justinc324/processing_printer/BrachioGraph/docs/images/anselmo.jpg

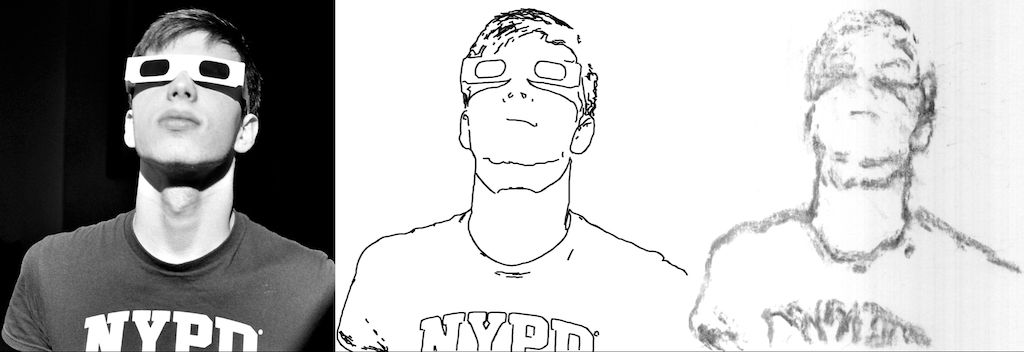
BrachioGraph/docs/images/anselmo.jpg
