justinc324/processing_printer/BrachioGraph/docs/images/brachiograph-clothespeg-closeup.jpg

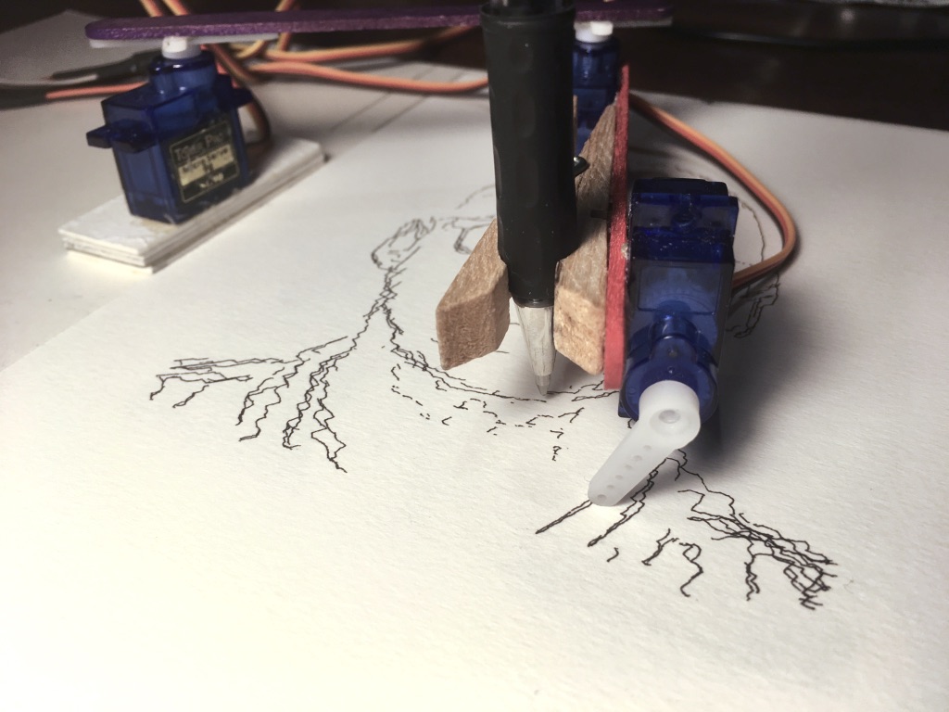
BrachioGraph/docs/images/brachiograph-clothespeg-closeup.jpg
