justinc324/processing_printer/BrachioGraph/docs/images/brachiograph-with-card.jpg

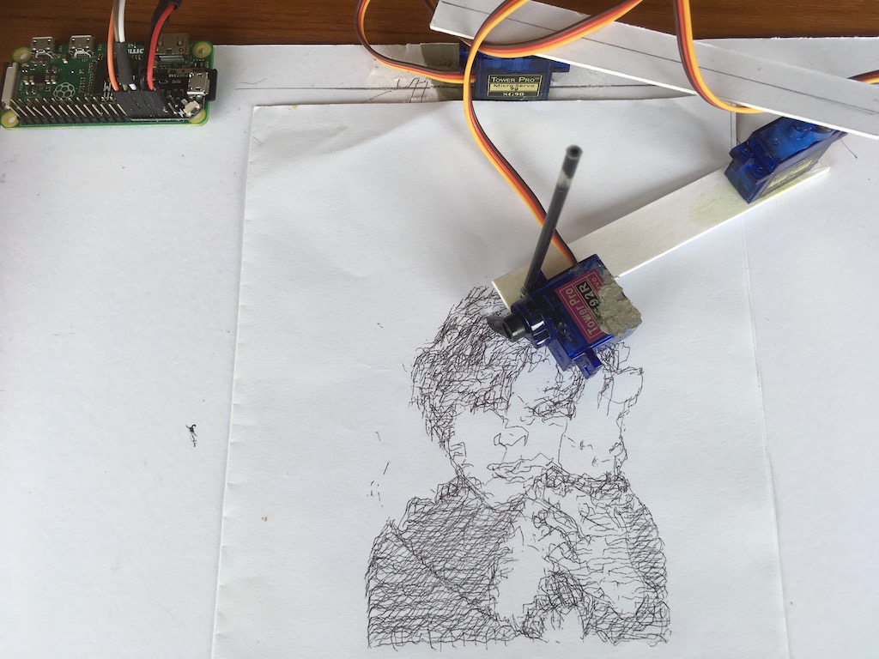
BrachioGraph/docs/images/brachiograph-with-card.jpg
