justinc324/processing_printer/BrachioGraph/docs/images/brachiograph-with-pencil.jpg

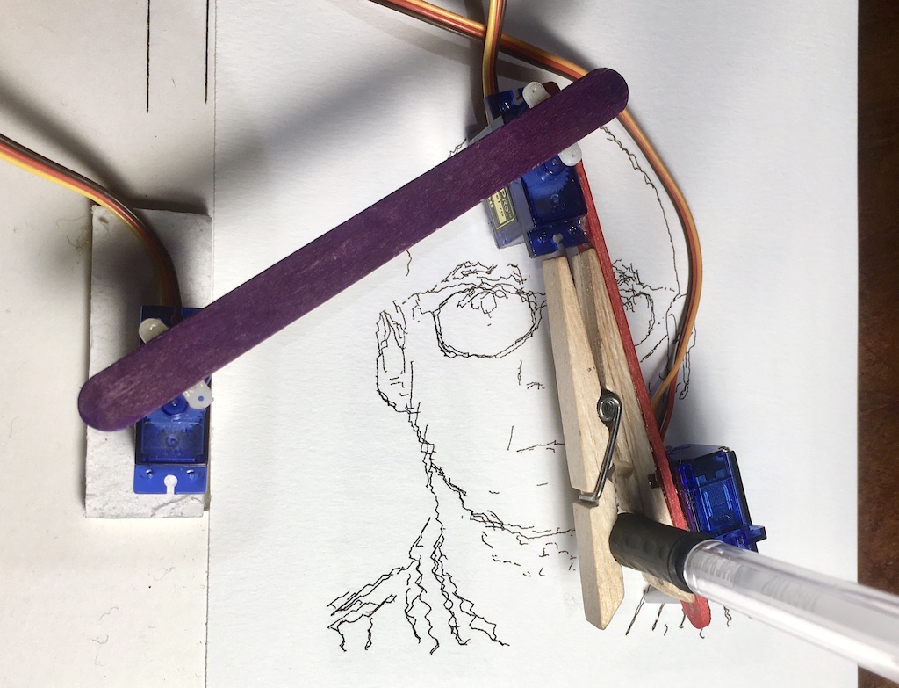
BrachioGraph/docs/images/brachiograph-with-pencil.jpg
