justinc324/processing_printer/BrachioGraph/docs/images/card-arms-and-motors.jpg

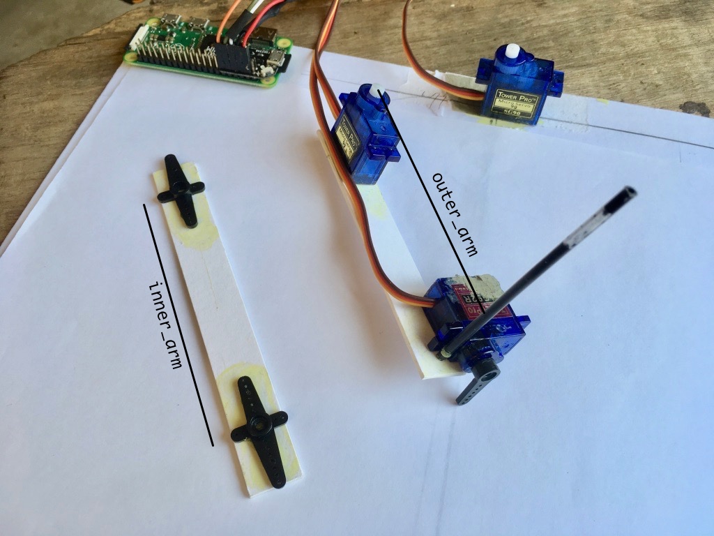
BrachioGraph/docs/images/card-arms-and-motors.jpg
