justinc324/processing_printer/BrachioGraph/docs/images/card-starting-position.jpg

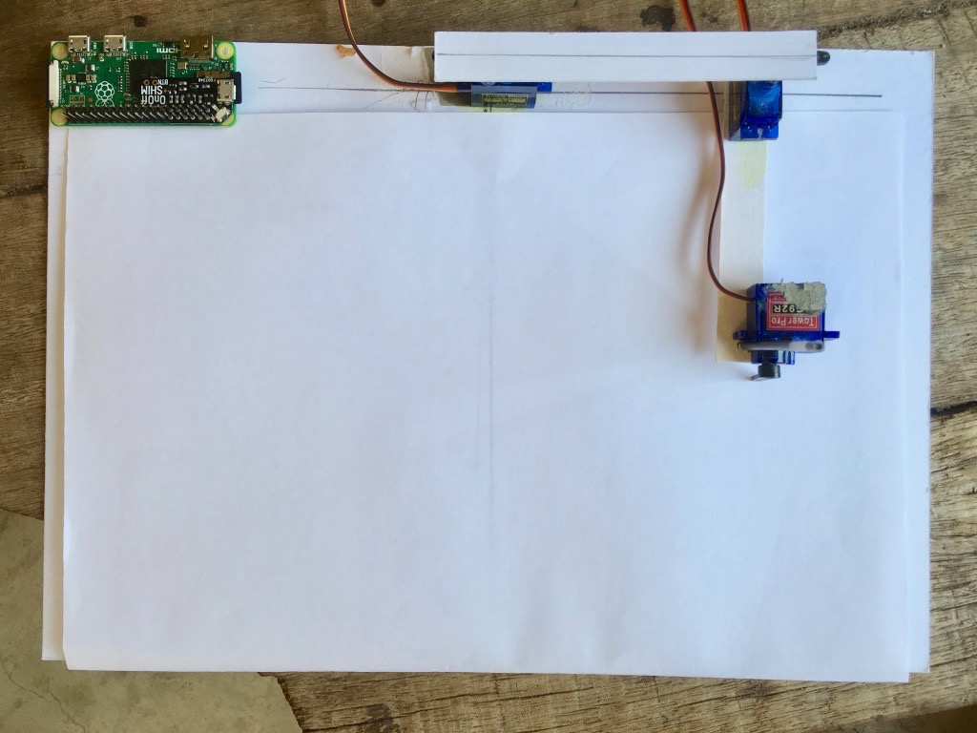
BrachioGraph/docs/images/card-starting-position.jpg
