justinc324/processing_printer/BrachioGraph/docs/images/fiat.jpg

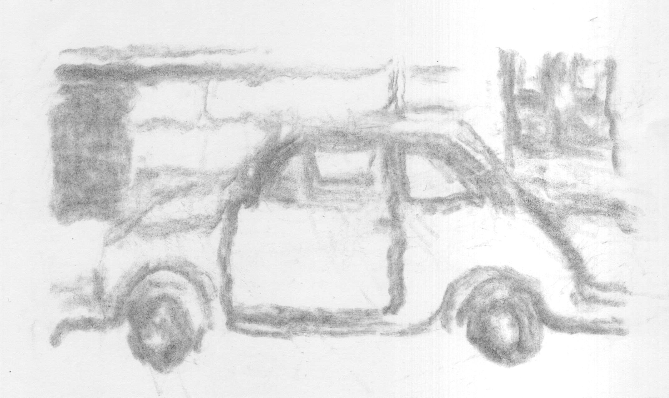
BrachioGraph/docs/images/fiat.jpg
