justinc324/processing_printer/BrachioGraph/docs/images/geometry.png

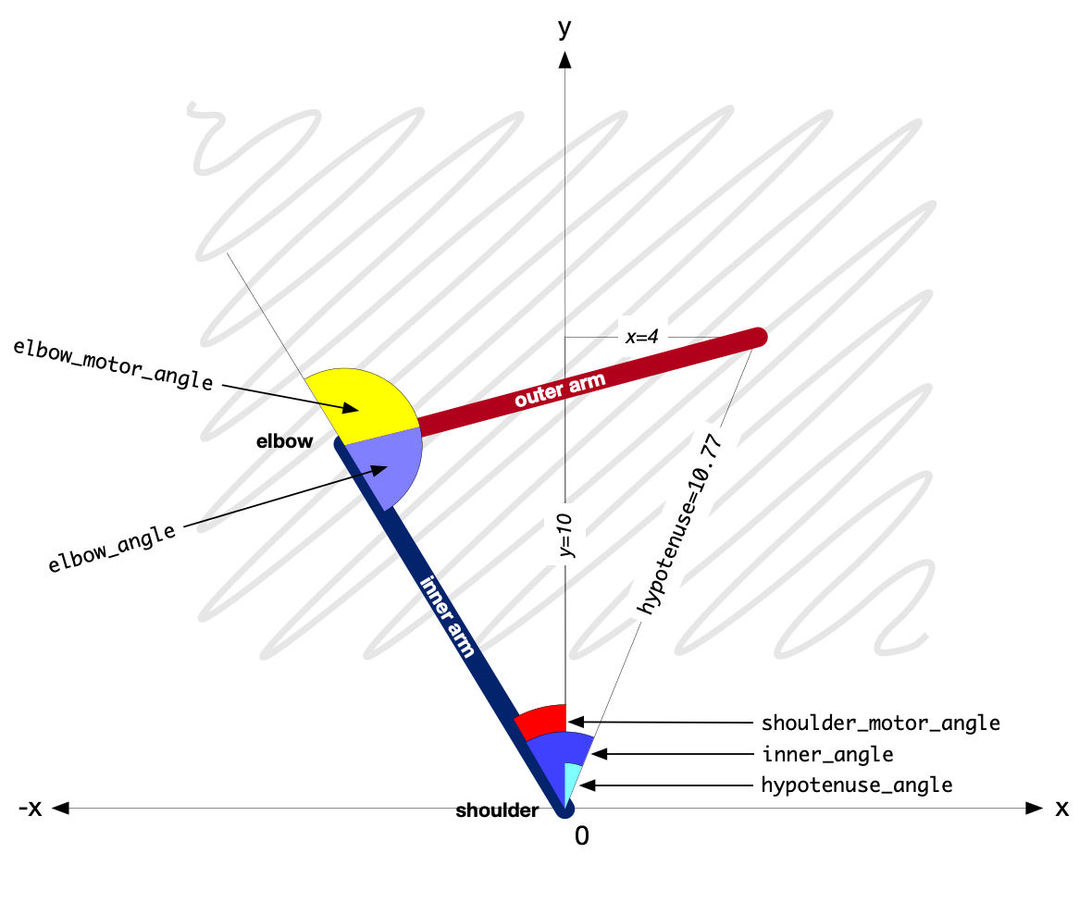
BrachioGraph/docs/images/geometry.png
