justinc324/processing_printer/BrachioGraph/docs/images/lifting-mechanism.jpg

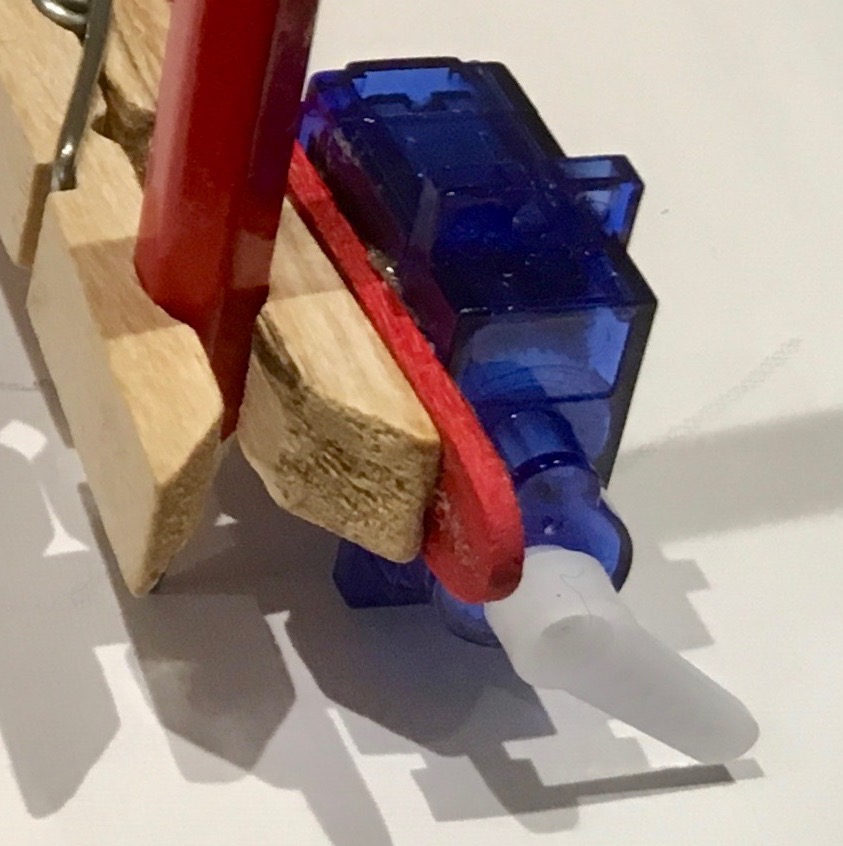
BrachioGraph/docs/images/lifting-mechanism.jpg
