justinc324/processing_printer/BrachioGraph/docs/images/peg-holder.jpg

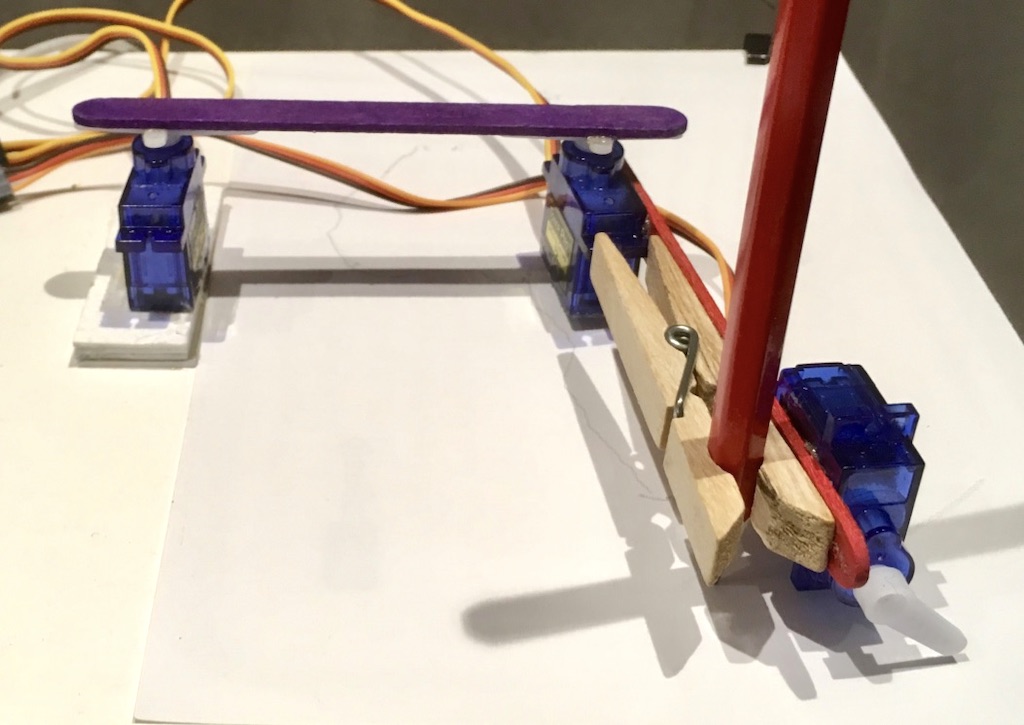
BrachioGraph/docs/images/peg-holder.jpg
