justinc324/processing_printer/BrachioGraph/docs/images/pen-and-lift.jpg

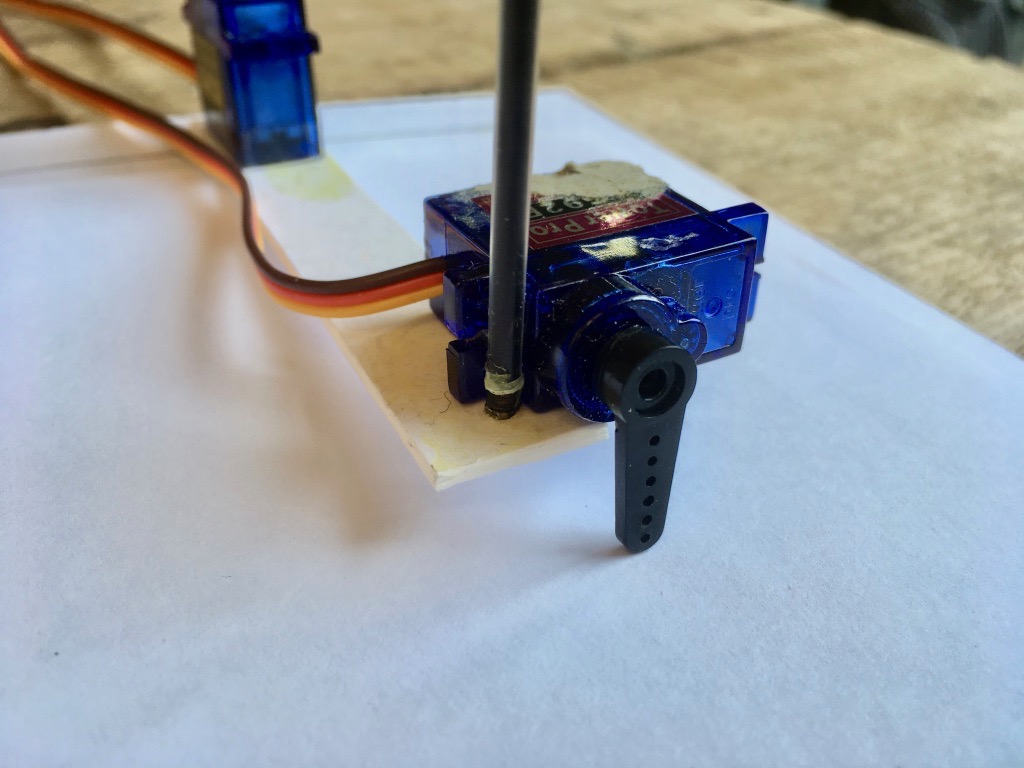
BrachioGraph/docs/images/pen-and-lift.jpg
