justinc324/processing_printer/BrachioGraph/docs/images/plotting-area.png

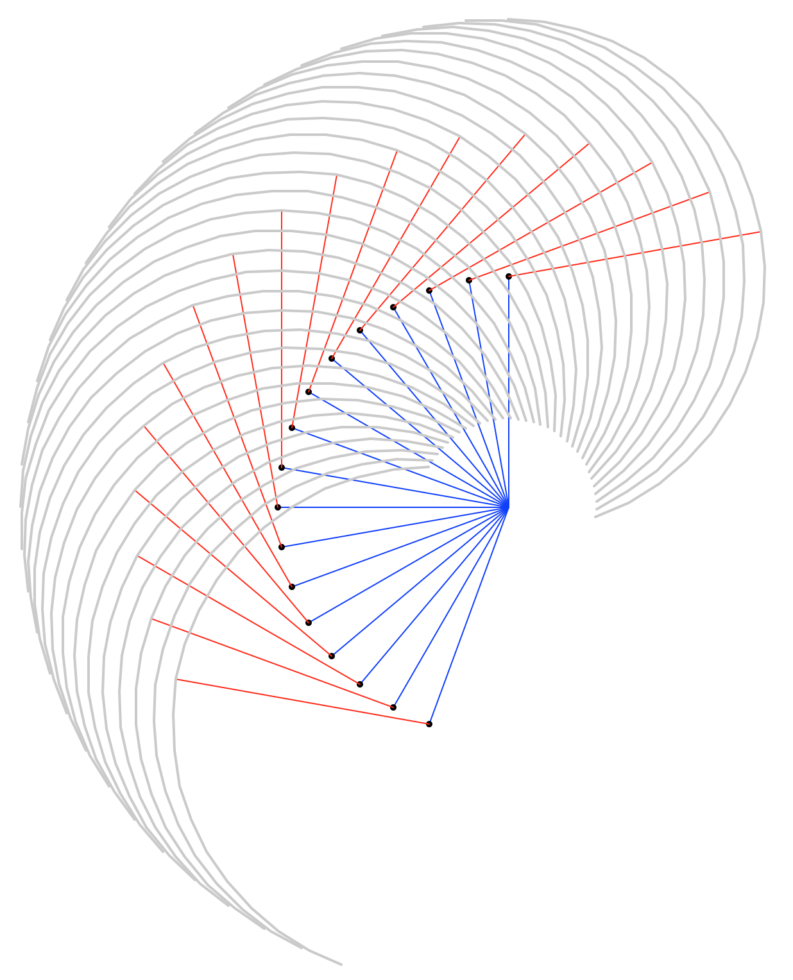
BrachioGraph/docs/images/plotting-area.png
