justinc324/processing_printer/BrachioGraph/docs/images/prague2.jpg

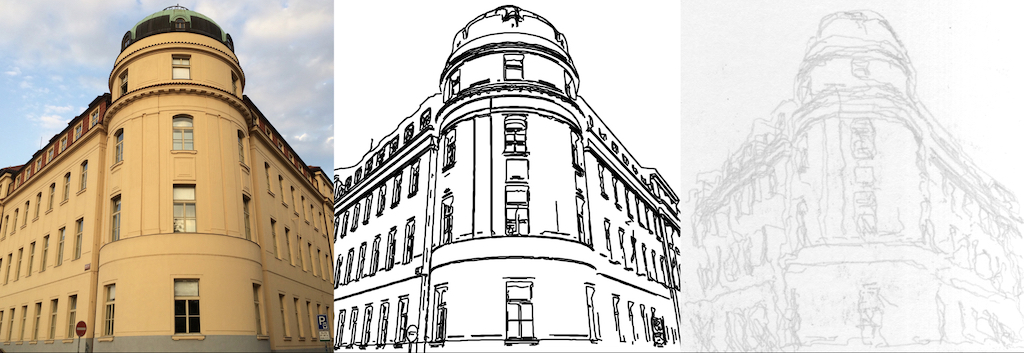
BrachioGraph/docs/images/prague2.jpg
