justinc324/processing_printer/BrachioGraph/docs/images/prague.jpg

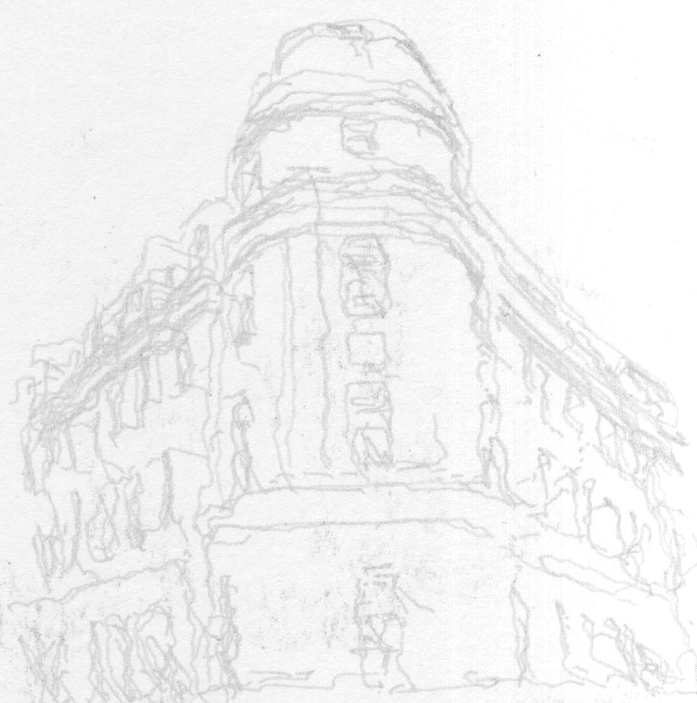
BrachioGraph/docs/images/prague.jpg
