justinc324/processing_printer/BrachioGraph/docs/images/pw-angles.png

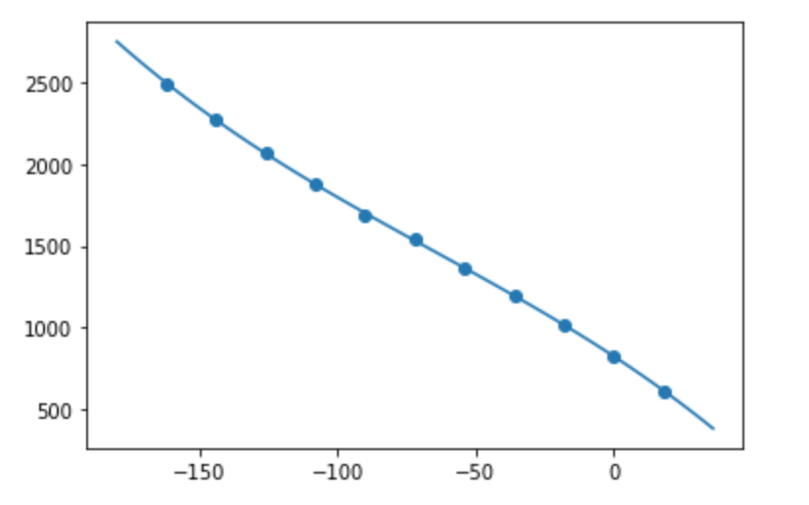
BrachioGraph/docs/images/pw-angles.png
