justinc324/processing_printer/BrachioGraph/docs/images/readme_combined_image.png

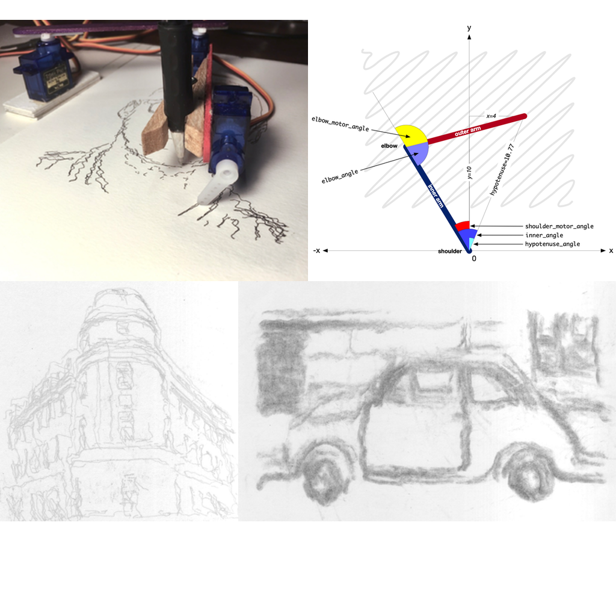
BrachioGraph/docs/images/readme_combined_image.png
