justinc324/processing_printer/BrachioGraph/docs/images/starting-position.jpg

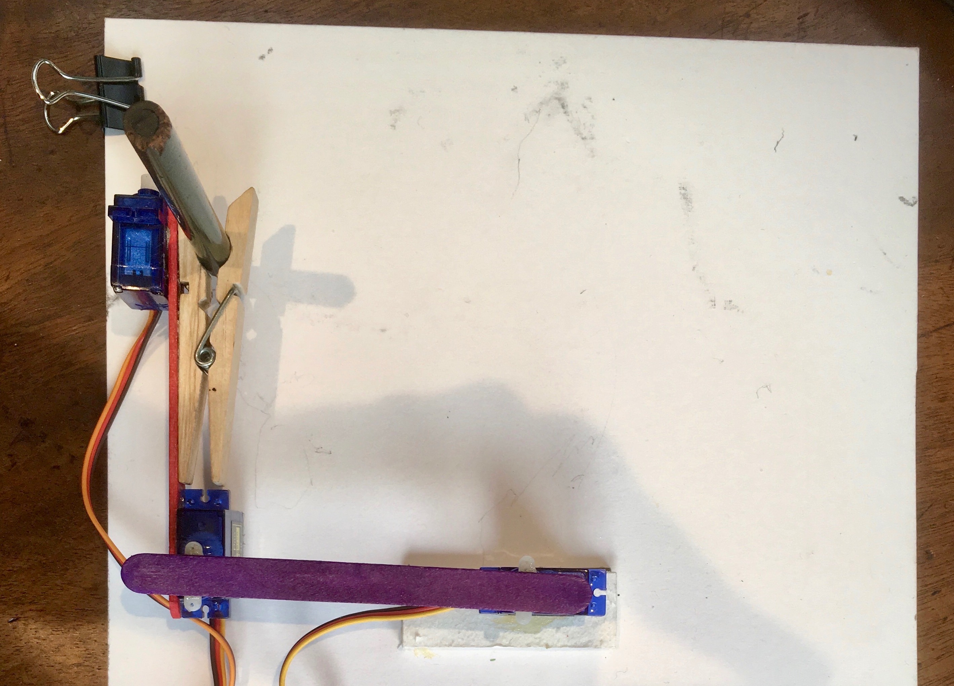
BrachioGraph/docs/images/starting-position.jpg
