justinc324/processing_printer/BrachioGraph/docs/images/the-author.jpg

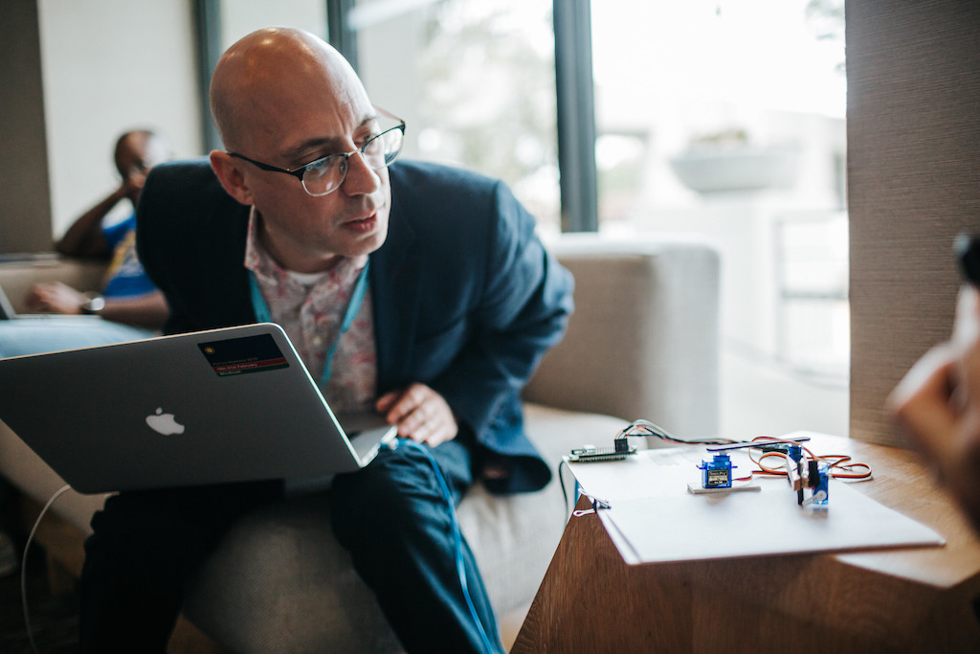
BrachioGraph/docs/images/the-author.jpg
