justinc324/processing_printer/BrachioGraph/docs/images/x-and-y.jpg

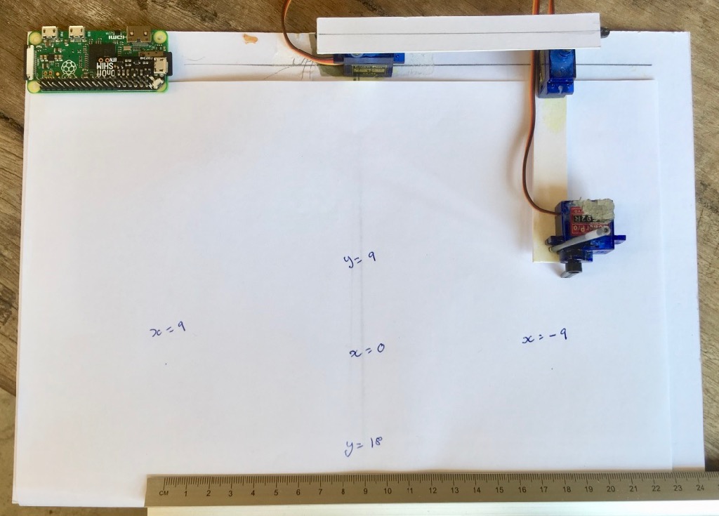
BrachioGraph/docs/images/x-and-y.jpg
