justinc324/processing_printer/BrachioGraph/docs/source_files/IMG_0271.jpeg

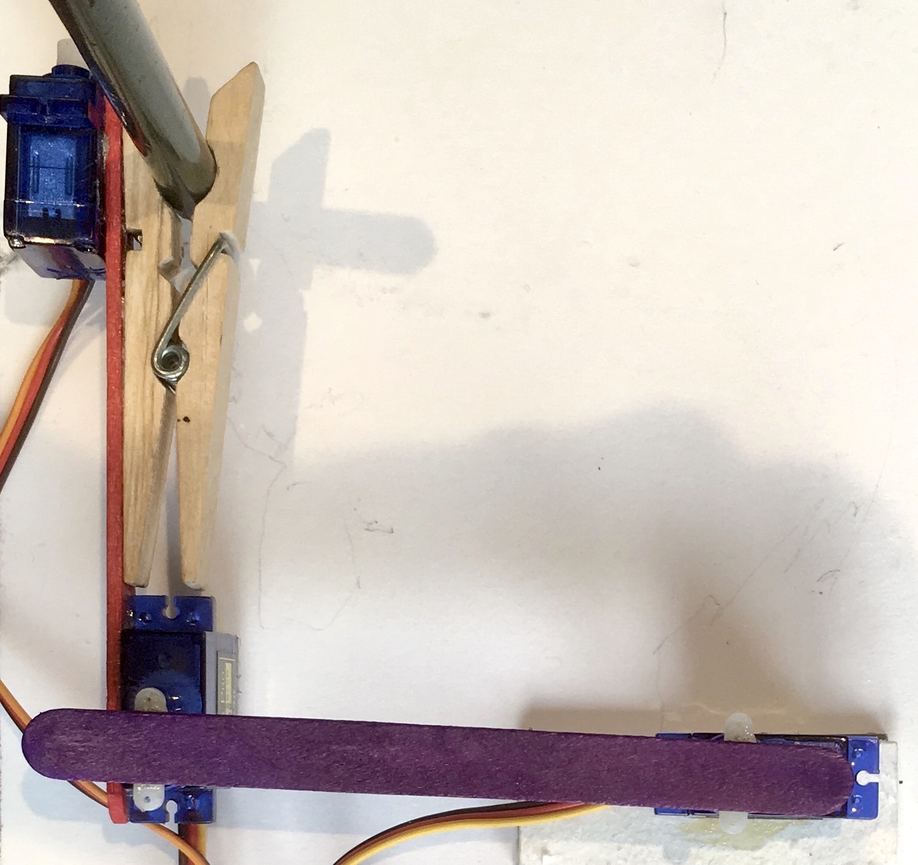
BrachioGraph/docs/source_files/IMG_0271.jpeg
