justinc324/processing_printer/BrachioGraph/docs/source_files/Plotter images/IMG_0226 (1).jpg

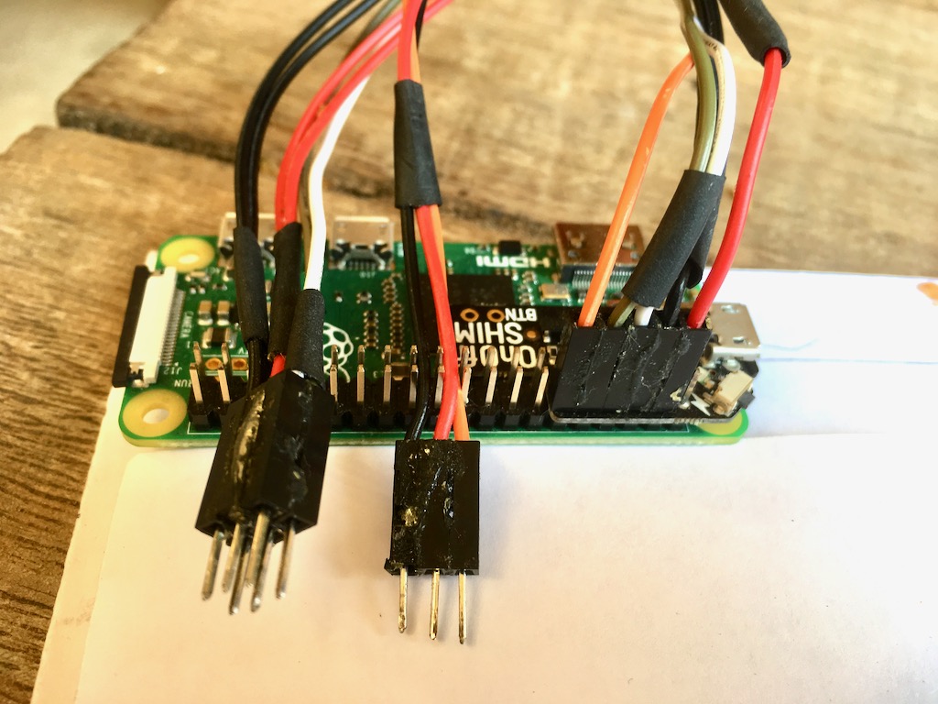
BrachioGraph/docs/source_files/Plotter images/IMG_0226 (1).jpg
