justinc324/processing_printer/BrachioGraph/DrawSomethingKeys/SaveDraw.jpg

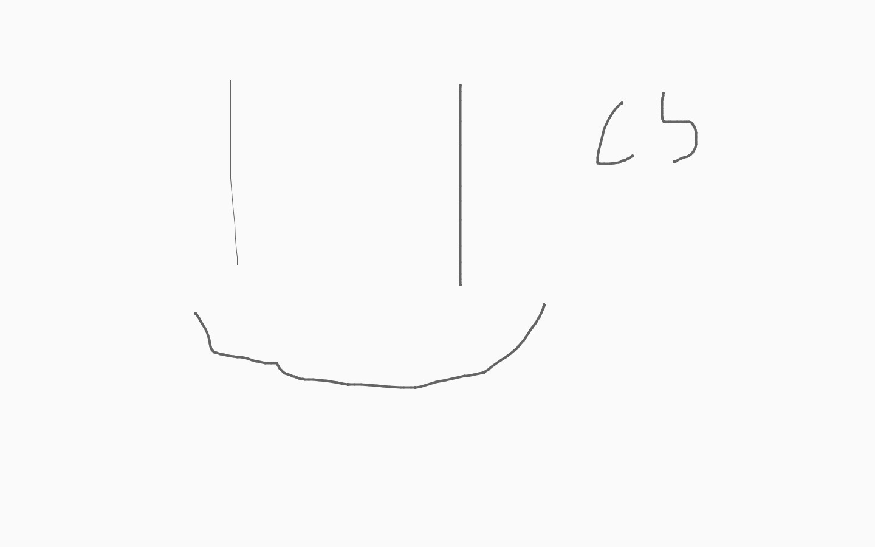
BrachioGraph/DrawSomethingKeys/SaveDraw.jpg
