justinc324/processing_printer/BrachioGraph/images/africa-solid.jpg

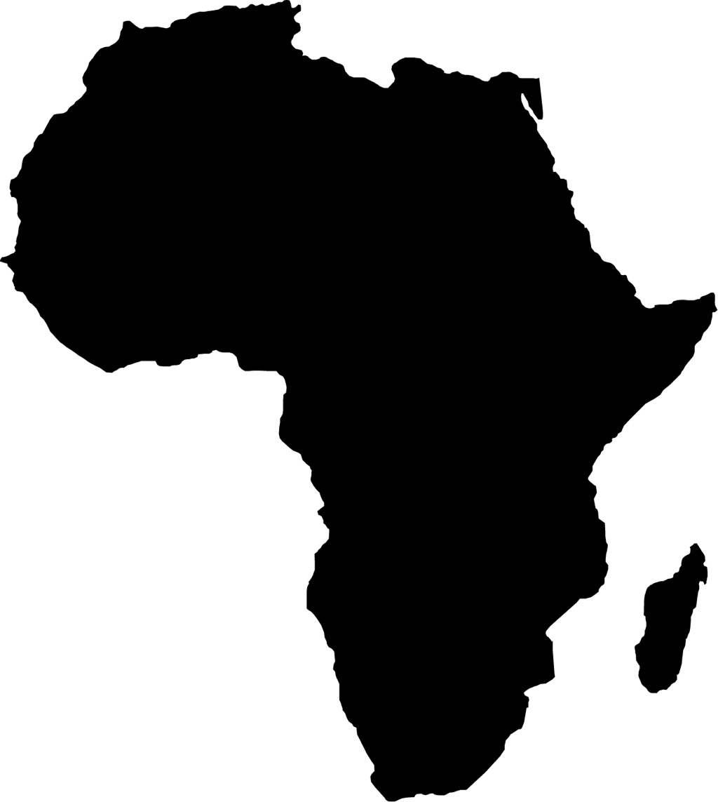
BrachioGraph/images/africa-solid.jpg
