justinc324/processing_printer/DrawSave/SaveDraw.jpg

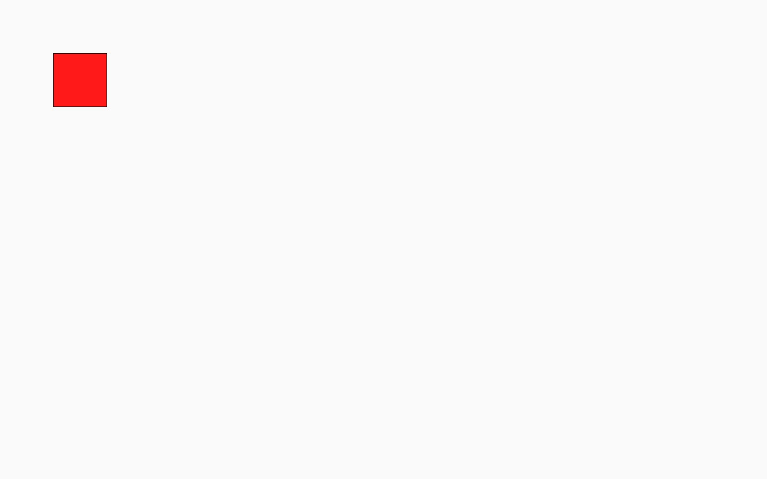
DrawSave/SaveDraw.jpg
