justinc324/processing_printer/DrawSomethingKeys/SaveDraw.jpg

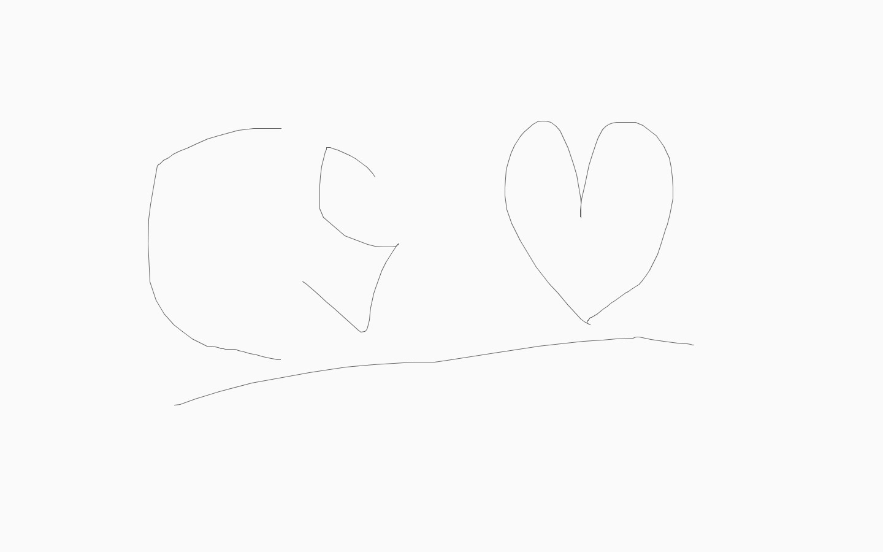
DrawSomethingKeys/SaveDraw.jpg
