justinc324/processing_printer/IMG_2588.jpg

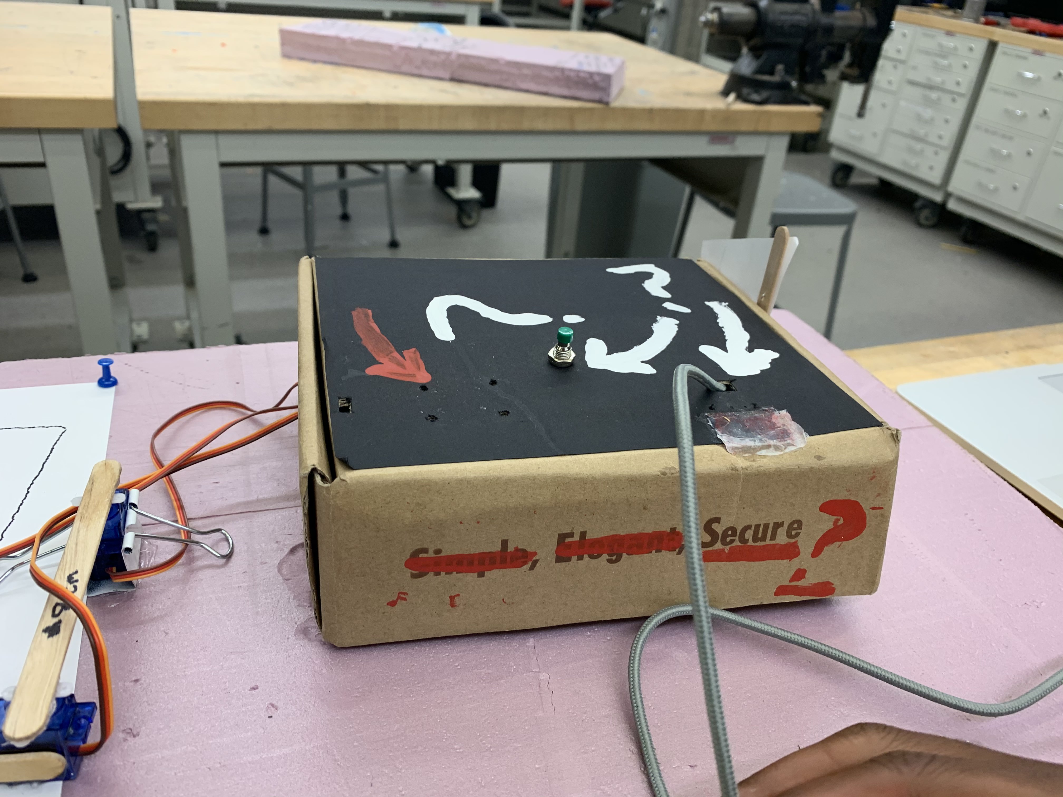
IMG_2588.jpg
