justinc324/processing_printer/BrachioGraph/docs/how-to/index.rst

How-to guides
=========================================================

.. toctree::
    :maxdepth: 1

    Use the linedraw library to vectorise bitmap images <use-linedraw>
    Improve the calibration of the ploter and its servos <improve-calibration>
    Visualise the behaviour of the plotter and its components <visualise-behaviour>
    Prepare a Raspberry Pi Zero for use with the plotter <prepare-pi>
    Build a PantoGraph, an alternative plotter design <pantograph>
