justinc324/processing_printer/controller.py

from BrachioGraph.brachiograph import BrachioGraph
from BrachioGraph.Pde2jsonInternal import *

import RPi.GPIO as GPIO
import time

GPIO.setmode(GPIO.BCM)

GPIO.setup(23, GPIO.IN, pull_up_down=GPIO.PUD_UP)

# initialize the BrachioGraph
bg = BrachioGraph(inner_arm=8, outer_arm=9.5, bounds=[-10, 3, 6, 12])

while True:
	button_state = GPIO.input(23)
	if button_state == False:
		create_json()
		bg.plot_file("SaveDraw.jpg.json")
		time.sleep(4)
