justinc324/processing_printer/BrachioGraph/controller.py

from brachiograph import BrachioGraph
from Pde2jsonInternal import *

import RPi.GPIO as GPIO
import time

GPIO.setmode(GPIO.BCM)

GPIO.setup(23, GPIO.IN, pull_up_down=GPIO.PUD_UP)
GPIO.setup(2, GPIO.OUT)

flag = GPIO.PWM(2, 50)

flag.start(12.5)

# initialize the BrachioGraph
bg = BrachioGraph(inner_arm=8, outer_arm=9.5,
				  bounds=[-10, 3, 6, 12],
				  pw_up=1100, pw_down=800)

try:
	while True:
		button_state = GPIO.input(23)
		if button_state == False:
			flag.ChangeDutyCycle(12.5)
			create_json()
			bg.plot_file("images/SaveDraw.jpg.json")
			flag.ChangeDutyCycle(7.5)
			time.sleep(4)
except KeyboardInterrupt:
	flag.stop()
	GPIO.cleanup()
